Dgluj/Stiffio/Informe Final/Anexos.tex

% TÍTULO
\section*{Anexos}
% ANEXO A =================================================================================================================
\section{Asignación de pines del circuito electrónico}
\label{anexo:ConexionPines}

\begin{table}[H]
    \centering
    \caption{Pines de conexión de la Pantalla TFT a la ESP32}
    \label{tab:ConexionPantalla}
    
    % {|l|l|} significa: Línea | Columna Izq | Línea | Columna Izq | Línea
    \begin{tabular}{|l|l|} 
        \hline
        \textbf{Pin Pantalla TFT} & \textbf{Pin ESP32} \\
        \hline
        VCC             & 3V3 \\
        \hline
        GND             & GND \\
        \hline
        CS              & GPIO 5 \\
        \hline
        RESET           & GPIO 4 \\
        \hline
        DC / RS         & GPIO 2 \\
        \hline
        SDI (MOSI)      & GPIO 23 \\
        \hline
        SCK             & GPIO 18 \\
        \hline
        LED             & 3V3 \\
        \hline
        SDO (MISO)      & GPIO 19 \\
        \hline
        T\_CLOCK (Touch)   & GPIO 18 \\
        \hline
        T\_CS (Touch)   & GPIO 15 \\
        \hline
        T\_DIN (Touch)   & GPIO 23 \\
        \hline
        T\_DO (Touch)   & GPIO 19 \\
        \hline
        T\_IRQ (Touch)   & GPIO 27 \\ 
        \hline

    \end{tabular}
\end{table}

\begin{table}[H]
    \centering
    \caption{Pines de conexión de los sensores MAX3012 a la ESP32}
    \label{tab:ConexionSensores}

    \begin{tabular}{|l|l|} 
        \hline
        \textbf{Pin Pantalla TFT} & \textbf{Pin ESP32} \\
        \hline
        VCC             & 3V3 \\
        \hline
        GND             & GND \\
        \hline
        SDA1              & GPIO 21 \\
        \hline
        SCL1           & GPIO 22 \\
        \hline
        SDA2         & GPIO 25 \\
        \hline
        SCL2      & GPIO 26 \\
        \hline

    \end{tabular}
\end{table}

% ANEXO B =================================================================================================================
\newpage
\section{Modelo 3D  de la carcasa}
\label{anexo:ModeloCarcasa}

\begin{figure}[H]
\centering
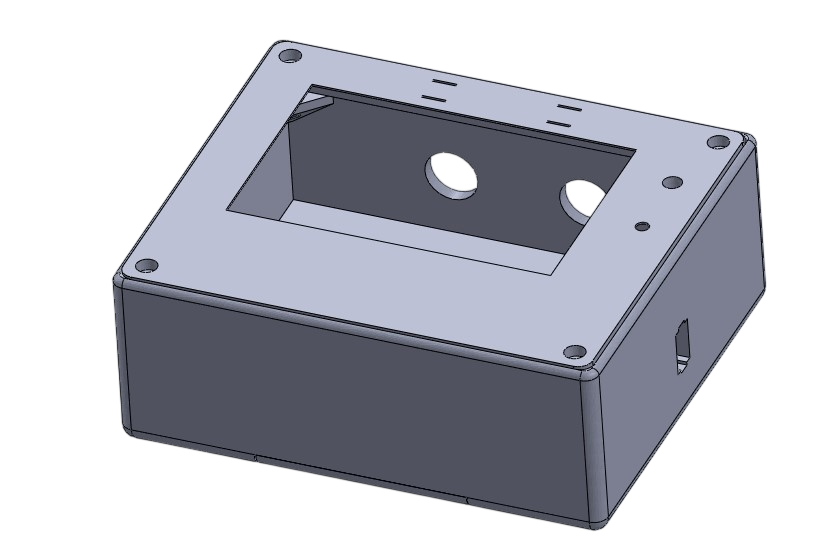
[picture p26: Informe Final/images/Carcasa Solid 1.png]

\captionsetup{margin=1.5cm, justification=centering}
\caption{Vista superior del modelo 3D de la carcasa.}
\label{fig:Carcasa Solid 1}
\end{figure}

\begin{figure}[H]
\centering
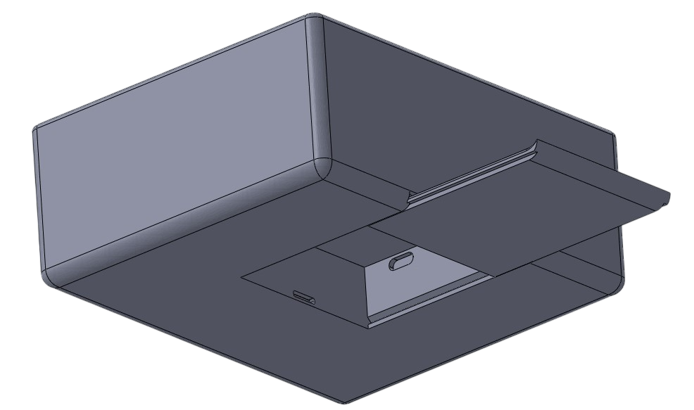
[picture p27: Informe Final/images/Carcasa Solid 2.png]

\captionsetup{margin=1.5cm, justification=centering}
\caption{Vista inferior del modelo 3D de la carcasa.}
\label{fig:Carcasa Solid 2}
\end{figure}

\begin{figure}[H]
\centering
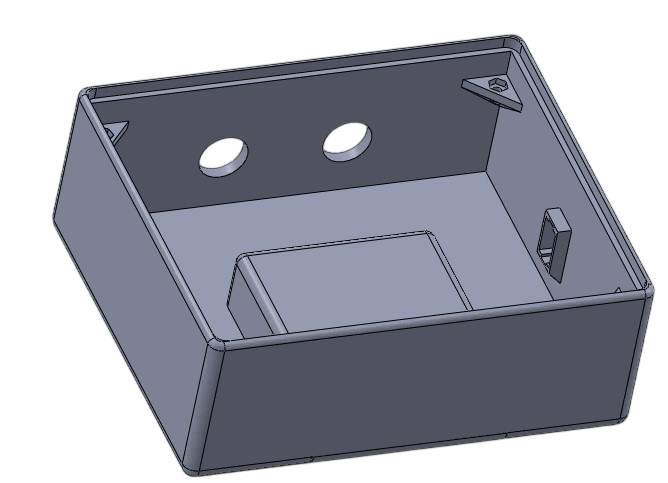
[picture p28: Informe Final/images/Carcasa Solid 3.png]

\captionsetup{margin=1.5cm, justification=centering}
\caption{Vista interior del modelo 3D de la carcasa.}
\label{fig:Carcasa Solid 3}
\end{figure}

% ANEXO C =================================================================================================================
\vspace{1cm}
\section{Modelo 3D del encapsulado de sensores}
\label{anexo:ModeloSensor}

\begin{figure}[H]
\centering
    
    \begin{minipage}[b]{0.45\textwidth}
        \centering
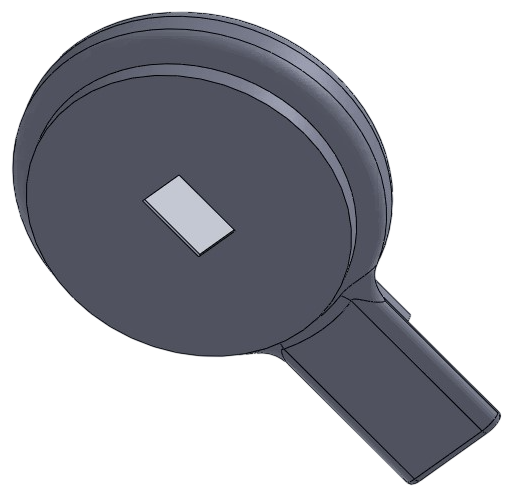
[picture p29: Informe Final/images/Sensor Solid.png]
        
    \end{minipage}
    \hspace{0.01cm} 
    \begin{minipage}[b]{0.45\textwidth}
        \centering
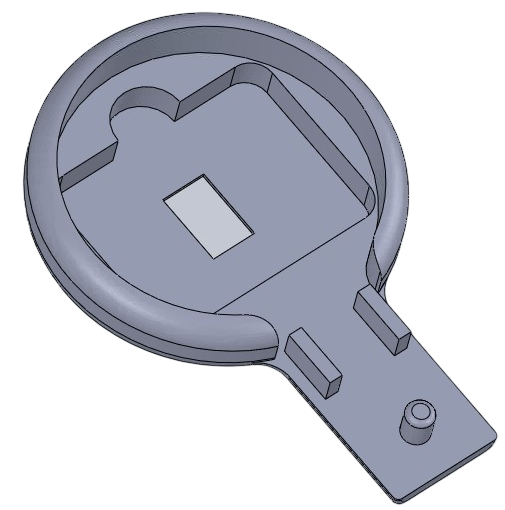
[picture p30: Informe Final/images/Sensor Solid 2.png]
        
    \end{minipage}
    
\captionsetup{margin=1.5cm, justification=centering}
        \caption{Vista frontal (izquierda) y posterior (derecha) del modelo 3D de la pieza frontal para el encapsulado del sensor.}
        \label{fig:Sensor Solid}
        \end{figure}

% ANEXO D =================================================================================================================
\newpage
\section{Estimación de distancia carotido-radial}
\label{anexo:FactorCorreccion}

\begin{table}[!ht]
    \centering
    \caption{Datos antropométricos empleados para calcular el factor de corrección por altura.}
    \begin{tabular}{|l|l|l|l|l|}
    \hline
        Edad & Sexo & Altura (cm) & Distancia medida (cm) & Factor de corrección \\ \hline
        61 & Femenino & 155 & 65 & 0,4193548387 \\ \hline
        62 & Masculino & 179 & 86 & 0,4804469274 \\ \hline
        22 & Femenino & 168 & 72 & 0,4285714286 \\ \hline
        22 & Femenino & 175 & 73 & 0,4171428571 \\ \hline
        22 & Femenino & 155 & 69 & 0,4451612903 \\ \hline
        22 & Femenino & 159 & 72 & 0,4528301887 \\ \hline
        22 & Femenino & 180 & 80 & 0,4444444444 \\ \hline
        23 & Masculino & 180 & 81 & 0,45 \\ \hline
        23 & Masculino & 174 & 74 & 0,4252873563 \\ \hline
        22 & Masculino & 177 & 81 & 0,4576271186 \\ \hline
        23 & Masculino & 179 & 78 & 0,4357541899 \\ \hline
        22 & Masculino & 185 & 80 & 0,4324324324 \\ \hline
        23 & Masculino & 177 & 75 & 0,4237288136 \\ \hline
        23 & Masculino & 192 & 80 & 0,4166666667 \\ \hline
        24 & Femenino & 154 & 64 & 0,4155844156 \\ \hline
        24 & Femenino & 170 & 73 & 0,4294117647 \\ \hline
        25 & Femenino & 159 & 71 & 0,4465408805 \\ \hline
        24 & Femenino & 174 & 82 & 0,4712643678 \\ \hline
        22 & Femenino & 158 & 72 & 0,4556962025 \\ \hline
        22 & Femenino & 164 & 70 & 0,4268292683 \\ \hline
        23 & Masculino & 167 & 70 & 0,4191616766 \\ \hline
        22 & Femenino & 159 & 66 & 0,4150943396 \\ \hline
        24 & Femenino & 162 & 71 & 0,4382716049 \\ \hline
        23 & Masculino & 178 & 78 & 0,4382022472 \\ \hline
        23 & Femenino & 168 & 74 & 0,4404761905 \\ \hline
        23 & Femenino & 165 & 68 & 0,4121212121 \\ \hline
        25 & Masculino & 176 & 81 & 0,4602272727 \\ \hline
        62 & Masculino & 187 & 78 & 0,4171122995 \\ \hline
        61 & Femenino & 157 & 67 & 0,4267515924 \\ \hline
        60 & Masculino & 180 & 82 & 0,4555555556 \\ \hline
        60 & Femenino & 150 & 62 & 0,4133333333 \\ \hline
        20 & Femenino & 161 & 72 & 0,4472049689 \\ \hline
        ~ & ~ & ~ & ~ & ~ \\ \hline
        ~ & ~ & ~ & Factor de correccion final & 0,4361964921 \\ \hline
    \end{tabular}
\end{table}

% ANEXO E =================================================================================================================
\newpage
\section{Reporte PDF}
\label{anexo:ReportePDF}

\begin{figure}[H]
\centering
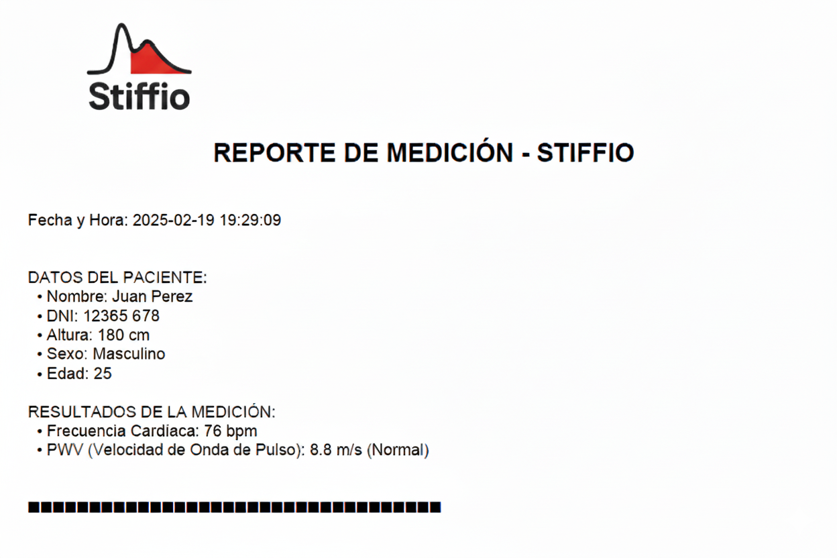
[picture p31: Informe Final/images/Reporte PDF.png]

\captionsetup{margin=1.5cm, justification=centering}
\caption{Modelo de reporte de medición exportable.}
\label{fig:ReportePDF}
\end{figure}
