Dgluj/Stiffio/Informe Final/images/Caja Solid.png

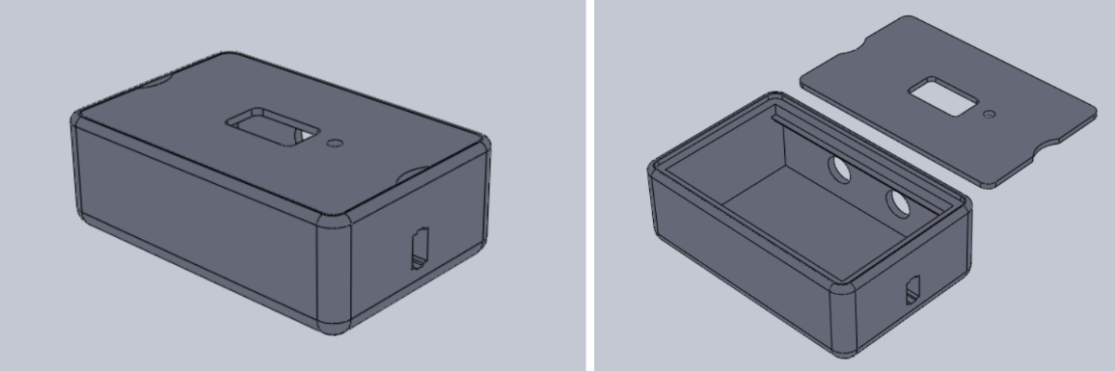
Informe Final/images/Caja Solid.png
