Dgluj/Stiffio/Informe Final/images/Sensor 2.png

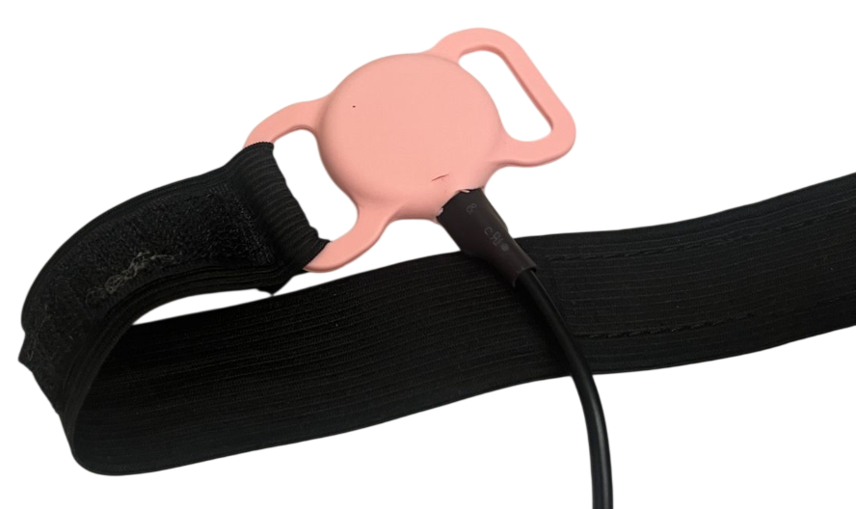
Informe Final/images/Sensor 2.png
