Dgluj/Stiffio/Informe Final/images/Sensores.png

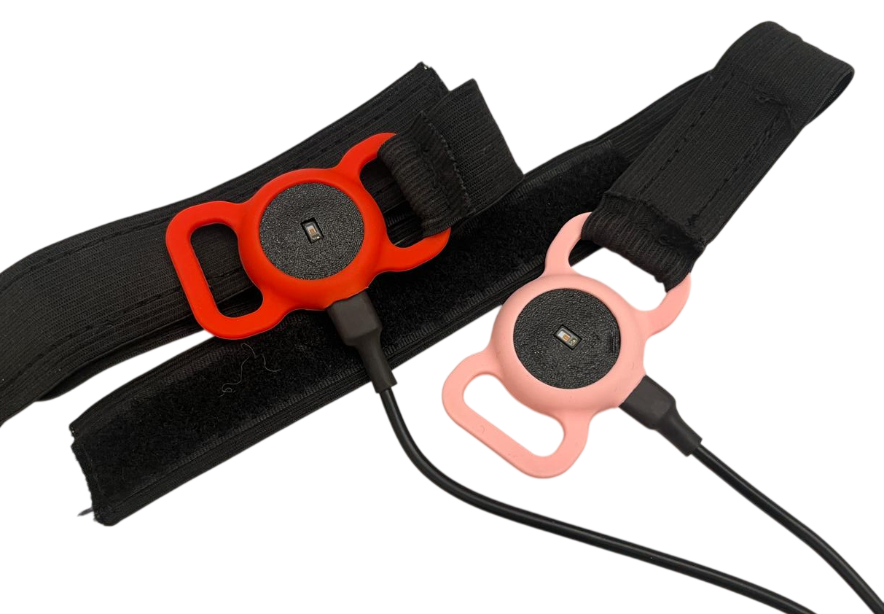
Informe Final/images/Sensores.png
