Dgluj/Stiffio/(commit log)

2026-01-31 Modo CLARO
    - Interfaz en MODO CLARO para mejor visualización.
    - Bitmap del logo con fondo blanco
    - Cartel popup de edad y altura invalida.
    - Rotación de pantalla para que se vea bien en el layout de la carcasa
2026-02-01 MODOS VISUALIZACIÓN
    Agregue dos iconos para seleccionar el modo de visualización de la medición: 1. Métricas en grande
    2. Curvas con las métricas en chiquito abajo.
    Esran cargados los archivos con los mapas de bits de cada imagen
2026-02-01 Aviso Sensores no colocados
    La pantalla indica si el sensor 1, 2 o ambos estan desconectados, acompañado de una alerta sonora periodica que se repite hasta que se coloquen los sensores.
    También puse todos los bitmaps de las imagenes en un único archivo .h llamado bitmaps.h para no tener tantos archivos diferentes.
2026-02-01 CARTEL CONFIRMAR SALIR
    Agregue un popup que aparece al presionar el botón salir que te pregunta si quieres realizar una nueva medición. Presionar CANCELAR para volver a la medición, o SALIR para volver al menú principal.
2026-02-02 CONEXION WIFI
    La ESP detecta la red WiFi generada por la computadora y muestra el IP en pantalla. No se ven las señales en la interfaz aún
2026-02-02 PANTALLAS ESTUDIO CLINICO
    Agregue una pantalla para que muestre el display mientras se utiliza la app, y una pantalla por si no se logra la conexion wifi, con sus respectivos popups y alertas sonoras.
2026-02-04 wifi
    Cambio numero de pines para conexión a la ESP vieja.
2026-02-06 Cambio pines CS 5 y 15
    gpios 5 y 15 switcheados, CS y TCS.
2026-02-08 Informe
    Escribi objetivos y materiales y métodos (hardware). Agregue fotos de solid al anexo.
2026-02-08 Anexo A
    Asignación de pines del circuito electrónico
2026-02-08 Informe
    Descripción y Uso previsto. Agregue el diagrama de bloques. Despues haría uno tmb para la parte del software que sea mas específico del flujo de datos.
2026-02-11 time fix test rapido
    [Microcontrolador.ino]
2026-02-11 fix HR - sparkfun library
    [Microcontrolador.ino]
2026-02-12 Informe
    Agregue fotos en la sección Hardware. Escribi la sección Interfaces de Usuario (faltan fotos)
2026-02-14 Front
    Agregue DNI para usar de ID de paciente en la interfaz. Tuve que crear un archivo con datos de ejemplo porque el viejo como tenia otro formato no servia
    [datos_stiffio.csv]
2026-02-14 VELOCIDAD I2C
    cambiamos de 400000 que era el máximo a 100000 para que no se trabe la conexion. Tambien agregue el chequeo del sensor distal en medicion activa para que verifique que estan ambos sensores listos antes de iniciar la medicion
2026-02-14 SENSOR DESCONECTADO
    Agregue chequeo con alerta de si se desconectan fisicamente los sensores
2026-02-15 fix hr with S2
    [Microcontrolador.ino]
2026-02-15 fix buffer size ptt/rr 10
    [Microcontrolador.ino]
2026-02-16 optimized calculation values with print
2026-02-16 Informe
    agregue fotitos del display en la sección interfaces de usuario
2026-02-17 fix serial print ip
    [Microcontrolador.ino]
2026-02-18 intento fix wifi failed
    [Microcontrolador.ino]
2026-02-18 fix funcional, pwv 25 muestras, buffer fijo + boton pause de test rapido + flag error medicion
    [Microcontrolador.ino]
2026-02-18 fix deteccion picos + interpolación parabólica
    [Microcontrolador.ino]
2026-02-18 fix BOM
2026-02-18 fix flag y botones
    [Microcontrolador.ino]
2026-02-18 fix estetico flag y boton pausa
    [Microcontrolador.ino]
2026-02-18 pies de onda / chau picos
2026-02-18 fix boton volver pantalla flag error medicion
    [Microcontrolador.ino]
2026-02-18 intento de mayor precision temporal
2026-02-19 Informe
    Analisis de repetitibilidad
2026-02-19 reversion 100kHz + fs 50Hz efectivos
    [Microcontrolador.ino]
2026-02-19 filters back
2026-02-20 Informe
    Metodología de evaluación y validación
2026-02-21 visualizacion de picos off
2026-02-21 Informe Final Final
    pequeñas correcciones de formato
2026-02-21 Touch Botones
    Arregle posición del touch de los iconos de la barra superior en la ventana de visualización
    [Microcontrolador.ino]
2026-02-21 fix re-iniciar medicion
    [mediciones_pwv.csv]
2026-02-21 fix play pause
    [mediciones_pwv.csv]
2026-02-21 flag stop front ino
    [mediciones_pwv.csv]
2026-02-21 update datos
    [datos_stiffio.csv, mediciones_pwv.csv]
2026-02-21 fix borrar x indice
    [mediciones_pwv.csv]
2026-02-21 agrego regristro
    [mediciones_pwv.csv]
2026-02-22 fix comunicacion esp front
    [mediciones_pwv.csv]
2026-02-22 mejora graph
    [mediciones_pwv.csv]
2026-02-22 fix fluidez
    [mediciones_pwv.csv]
2026-02-22 fix escalado, chau normalizado maxadc
    [mediciones_pwv.csv]
2026-02-22 fix flow tiempo inicial
    [mediciones_pwv.csv]
2026-02-22 version final curvas front
    [mediciones_pwv.csv]
2026-02-22 + mediciones
    [mediciones_pwv.csv]
